CC-Ian/smartknob/cad/hacked-motor-mount 2.step

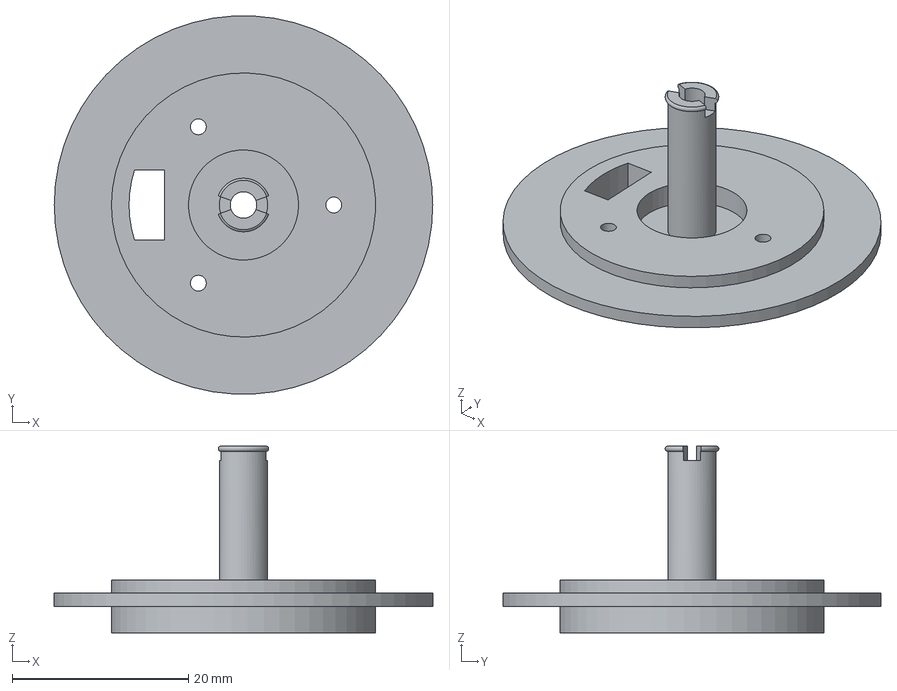
[picture p1: CAD file, 2025-04-29]
cad/hacked-motor-mount 2.step
43.0 x 42.9 x 21.2 mm
