CC-Ian/smartknob/electronics/view_base/LIB_WS2812B-4020/WS2812B-4020/3D/WS2812B-4020.stp

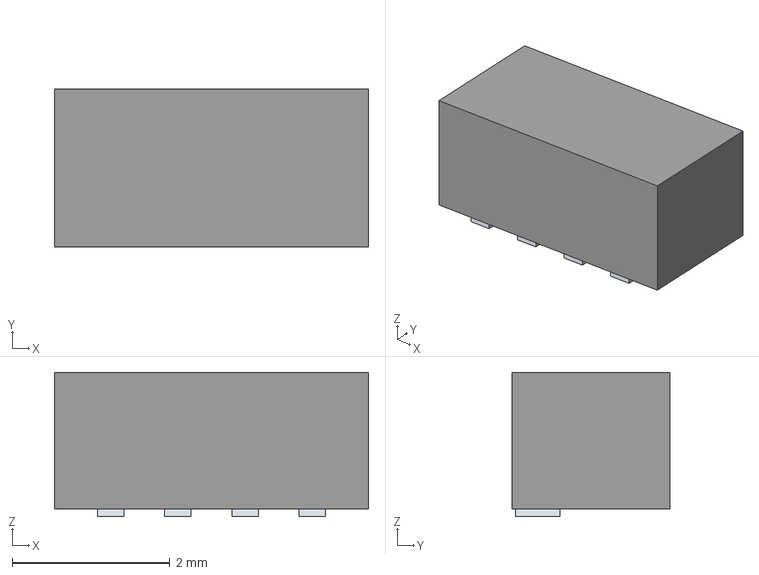
[picture p2: CAD file, 2025-03-28]
electronics/view_base/LIB_WS2812B-4020/WS2812B-4020/3D/WS2812B-4020.stp
3.98 x 2.00 x 1.83 mm
Pins
