CC-Ian/smartknob/cad/knob.step

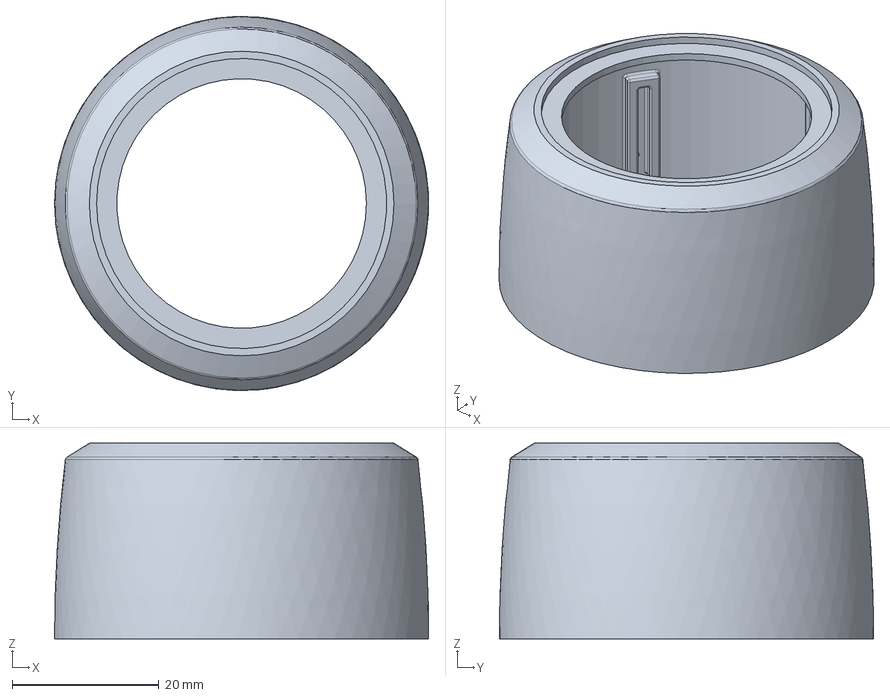
[picture p3: CAD file, 2025-04-29]
cad/knob.step
51.0 x 51.0 x 26.6 mm
