CC-Ian/smartknob/cad/Rotar Spacer.step

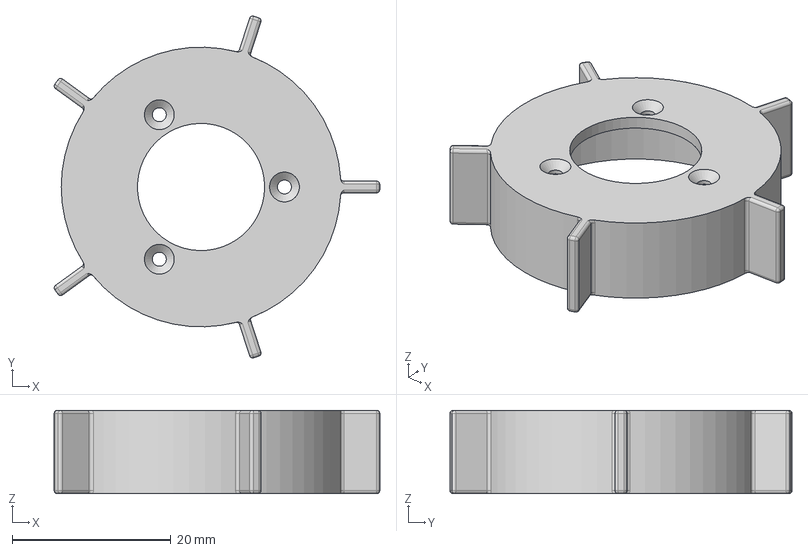
[picture p4: CAD file, 2025-04-29]
cad/Rotar Spacer.step
41.0 x 43.0 x 10.5 mm
