CC-Ian/smartknob/cad/hacked-motor-mount.step

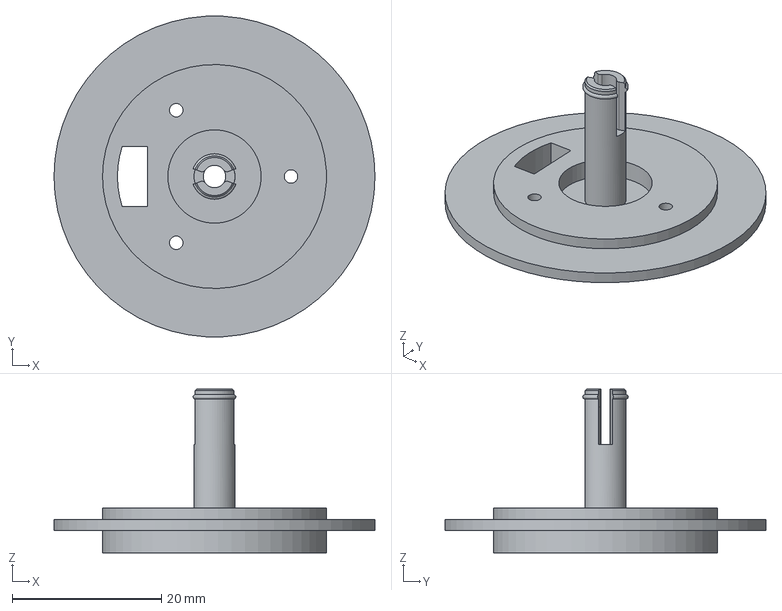
[picture p5: CAD file, 2025-04-29]
cad/hacked-motor-mount.step
43.0 x 42.9 x 21.9 mm
