CC-Ian/smartknob/cad/hacked rotor +.6mm.step

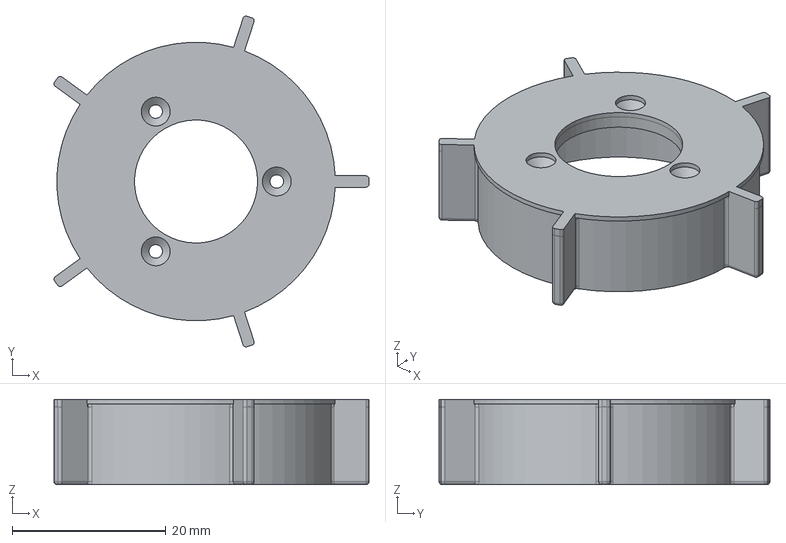
[picture p6: CAD file, 2025-04-29]
cad/hacked rotor +.6mm.step
41.0 x 43.0 x 11.1 mm
