CC-Ian/smartknob/cad/backplate.step

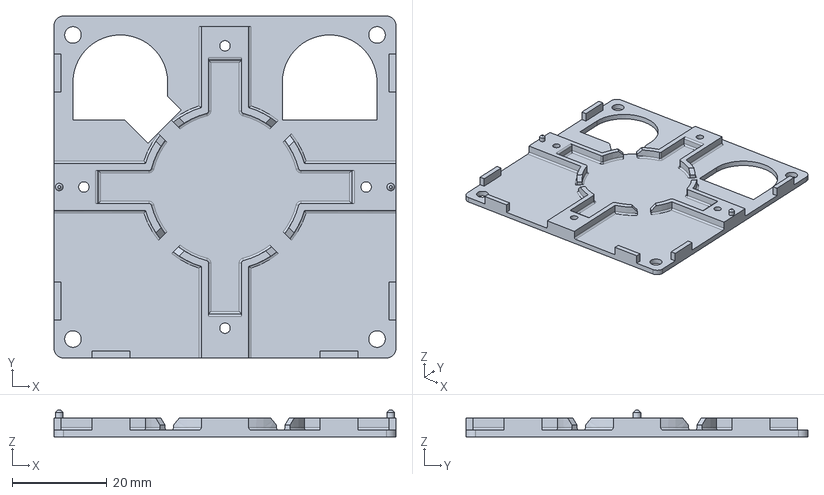
[picture p7: CAD file, 2025-03-28]
cad/backplate.step
72.2 x 72.2 x 5.70 mm
