CC-Ian/smartknob/cad/enclosure.step

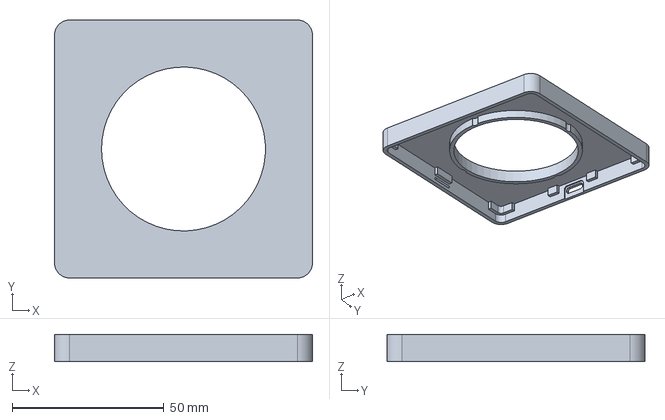
[picture p8: CAD file, 2025-03-28]
cad/enclosure.step
85.0 x 85.0 x 9.00 mm
