CC-Ian/smartknob/cad/screen platform.step

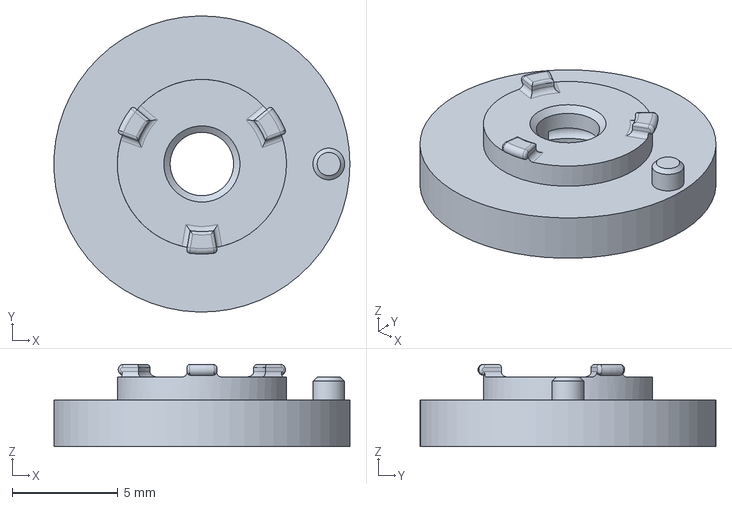
[picture p9: CAD file, 2025-03-28]
cad/screen platform.step
14.0 x 14.0 x 3.90 mm
