CC-Ian/smartknob/(list of files, cad)

Other CAD files:
cad/hacked-kbob.step
cad/base.step
