CC-Ian/smartknob/electronics/view_base/view_base.kicad_pcb

## KiCad design electronics/view_base/view_base.kicad_pcb (2025-04-29)

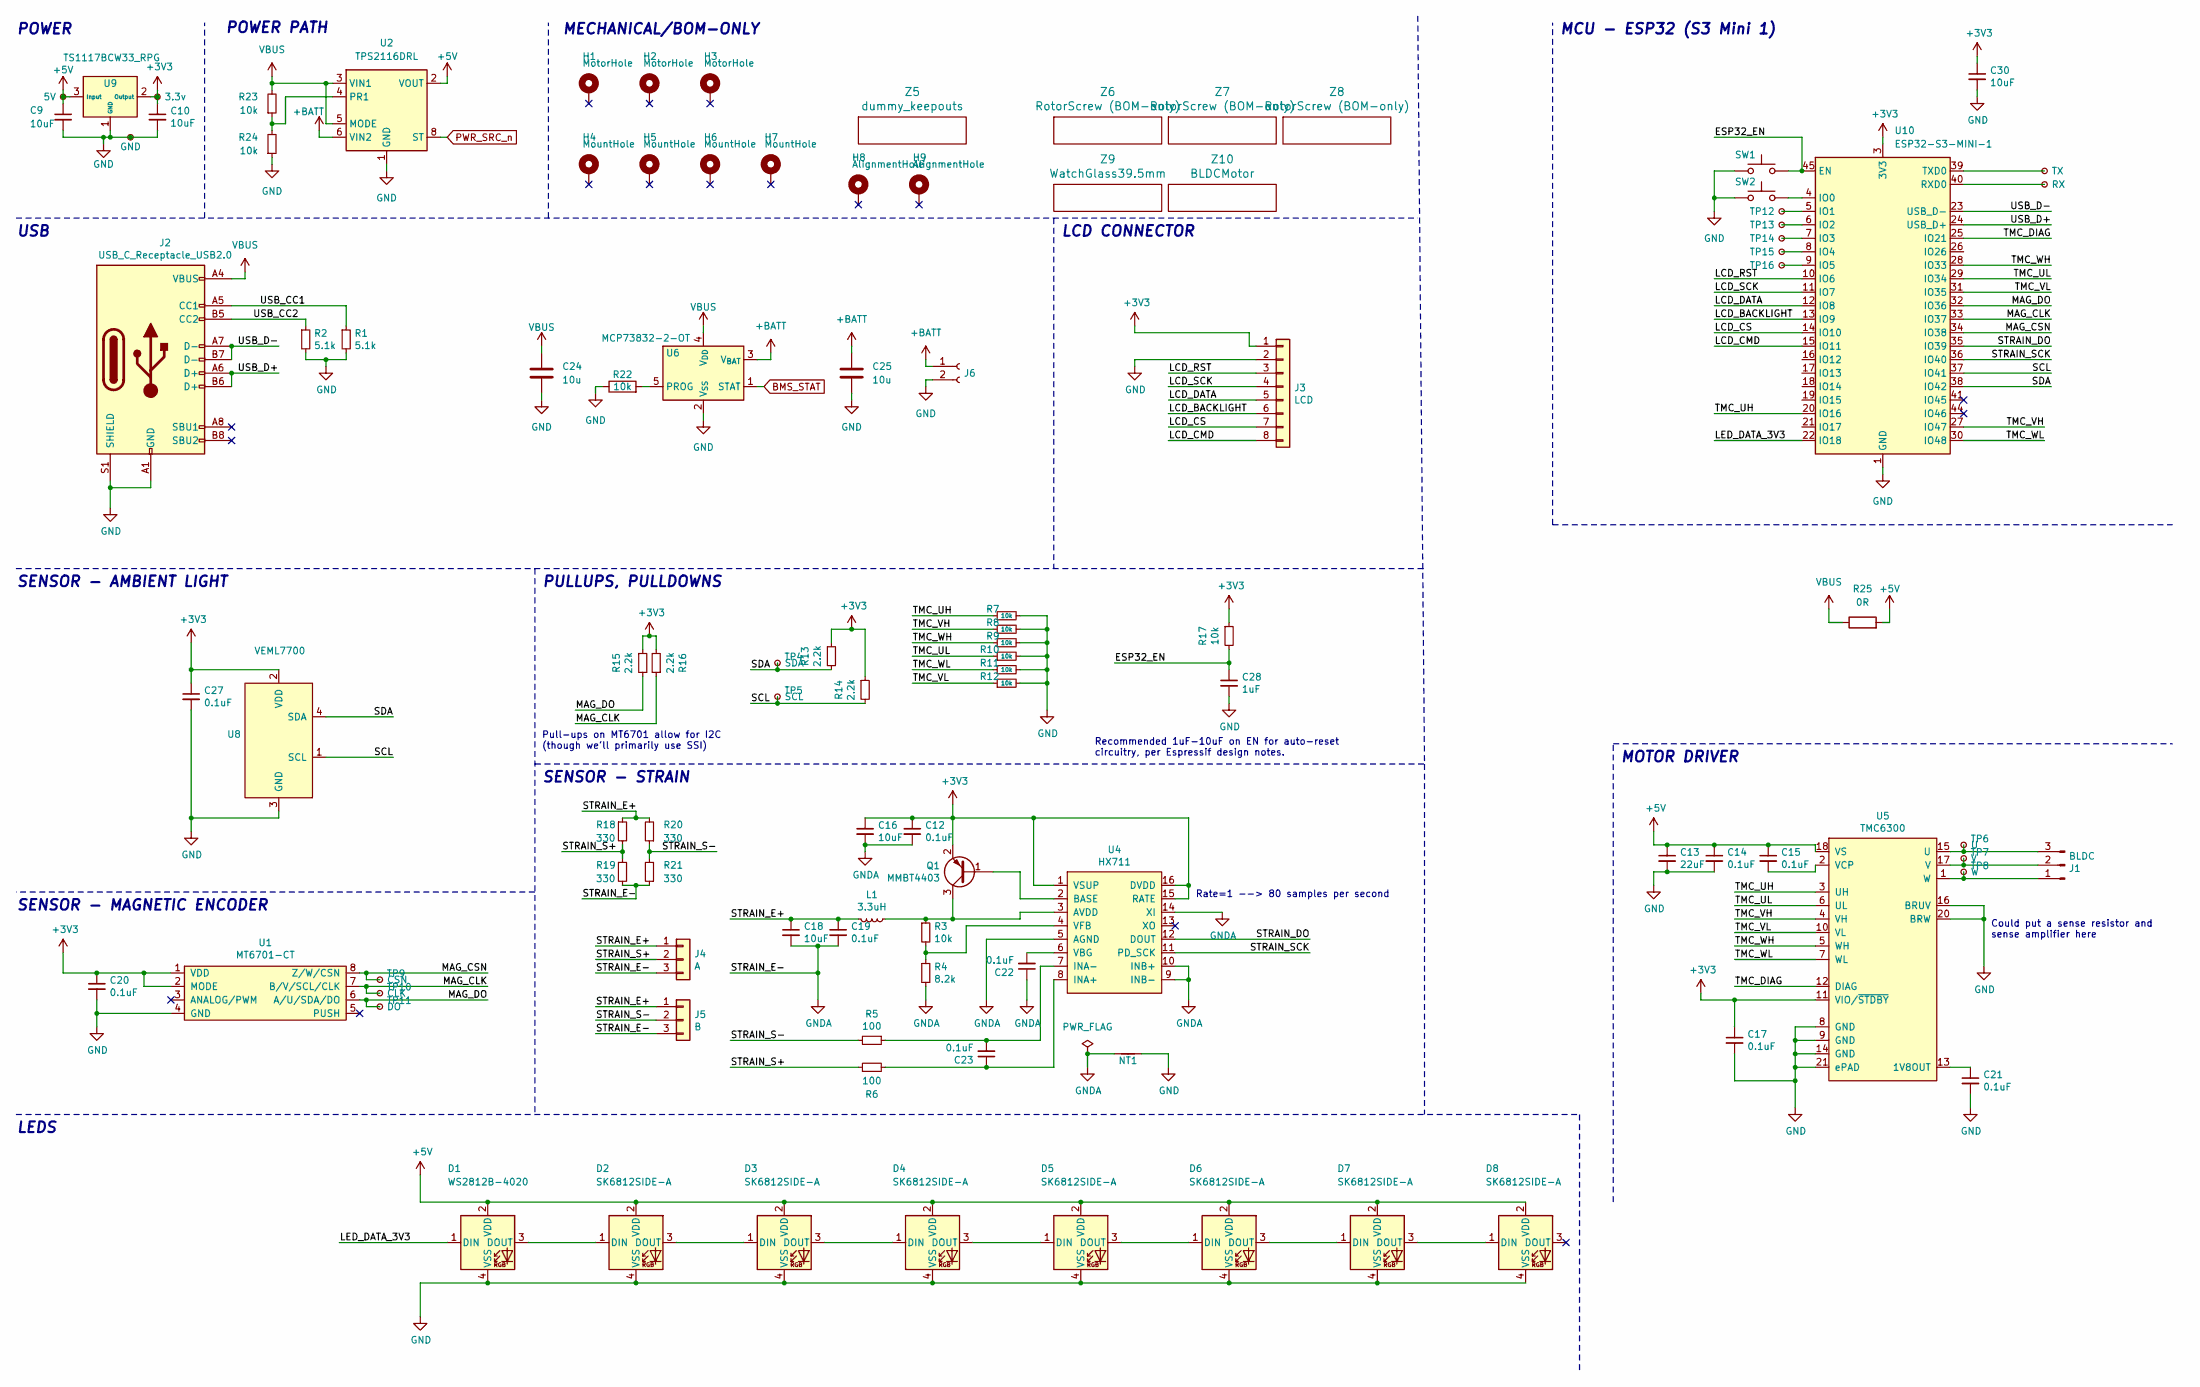
[picture p10: schematic view_base.kicad_sch, SmartKnob View]

Parts:
C9, C10, C16, C18, C30: 10uF; C_0603_1608Metric; LCSC C2922480
C12, C14, C15, C17, C19, C20, C21, C22, C23, C27: 0.1uF; C_0402_1005Metric; LCSC C1591
C13: 22uF; C_0603_1608Metric; LCSC C98190
C24, C25: 10u; C_0603_1608Metric
C28: 1uF; C_0402_1005Metric; Mouser 187-CL10A105KA8NNNC
D1: WS2812B-4020; WS2812B4020; Digikey 1528-4691-ND
D2, D3, D4, D5, D6, D7, D8: SK6812SIDE-A; WS2812B4020; Digikey 1528-4691-ND
H1, H2, H3: MotorHole; MountingHole_M1.6; LCSC C2931389
H4, H5, H6, H7: MountHole; MountingHole_2.2mm_M2_ISO7380_Pad_NonVirtual; LCSC C2911210 or C2911532 (screw), C2961595 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
H8, H9: AlignmentHole; MountingHole_2.2mm_M2_ISO7380_Pad_NonVirtual
J1: BLDC; 532610371; LCSC C293630
J2: USB_C_Receptacle_USB2.0; USB4510_NoPaste; LCSC C428463
J3: LCD; SolderPads_2mm_8
J4: A; SolderPads_2mm_3_STRAIN
J5: B; SolderPads_2mm_3_STRAIN
J6: Conn_01x02_Socket; PinHeader_1x02_P2.00mm_Vertical
L1: 3.3uH; L_0603_1608Metric; LCSC C307744
NT1: NetTie_2; NetTie-2_SMD_Pad0.5mm
Q1: MMBT4403; SOT-23; LCSC C78864
R1, R2: 5.1k; R_0402_1005Metric; LCSC C105580
R3, R7, R8, R9, R10, R11, R12, R17: 10k; R_0402_1005Metric; LCSC C98220
R4: 8.2k; R_0402_1005Metric; LCSC C114637
R5, R6: 100; R_0402_1005Metric; LCSC C319953
R13, R14, R15, R16: 2.2k; R_0402_1005Metric; LCSC C4190
R18, R19, R20, R21: 330; R_2512_6332Metric; LCSC C19866
R22, R23, R24: 10k; R_0402_1005Metric
R25: 0R; R_0603_1608Metric
SW1, SW2: SW_Push; T1B2QR
TP1: 5V; TestPoint_Pad_D2.0mm_ValueSilk
TP2: 3.3v; TestPoint_Pad_D2.0mm_ValueSilk
TP3: GND; TestPoint_Pad_D2.0mm_ValueSilk
TP4: SDA; TestPoint_Pad_D2.0mm_ValueSilk
TP5: SCL; TestPoint_Pad_D2.0mm_ValueSilk
TP6: U; TestPoint_Pad_D2.0mm_ValueSilk
TP7: V; TestPoint_Pad_D2.0mm_ValueSilk
TP8: W; TestPoint_Pad_D2.0mm_ValueSilk
TP9: CSN; TestPoint_Pad_D2.0mm_ValueSilk
TP10: CLK; TestPoint_Pad_D2.0mm_ValueSilk
TP11: DO; TestPoint_Pad_D2.0mm_ValueSilk
TP12, TP13, TP14, TP15, TP16: TestPoint_Small; TestPoint_Pad_D1.0mm
TP17: TX; TestPoint_Pad_D2.0mm_ValueSilk
TP18: RX; TestPoint_Pad_D2.0mm_ValueSilk
U1: MT6701-CT; SOIC-8_3.9x4.9mm_P1.27mm; LCSC C2856764, or C3003196
U2: TPS2116DRL; SOT-583-8; LCSC C3235557
U4: HX711; SOIC-16_3.9x9.9mm_P1.27mm; LCSC C43656
U5: TMC6300; QFN-20-1EP_3x3mm_P0.4mm_EP1.65x1.65mm; Digikey TMC6300-LA-T
U6: MCP73832-2-OT; SOT-23-5; LCSC C38066
U8: VEML7700; VEML7700-TOP; Digikey VEML7700-TT
U9: TS1117BCW33_RPG; SOT-223-3_TabPin2_GndOutIn; LCSC C6186
U10: ESP32-S3-MINI-1; ESP32-S2-MINI-1; LCSC C2913206
Z5: dummy_keepouts; ViewKeepouts3d
Z6, Z7, Z8: RotorScrew (BOM-only); bom_only_no_pin
Z9: WatchGlass39.5mm; bom_only_no_pin
Z10: BLDCMotor; bom_only_no_pin

Connections:
+3V3: C10.1, C12.1, C16.1, C17.1, C20.1, C27.1, C30.1, J3.1, Q1.2 (E), R13.1, R14.1, R15.1, R16.2, R17.1, TP2.1, U1.1 (VDD), U1.2 (MODE), U4.1 (VSUP), U4.15 (RATE), U4.16 (DVDD), U5.11 (VIO/~STDBY), U8.2 (VDD), U9.2 (Output), U10.3 (3V3)
+5V: C9.1, C13.1, C14.1, C15.1, D1.2 (VDD), D2.2 (VDD), D3.2 (VDD), D4.2 (VDD), D5.2 (VDD), D6.2 (VDD), D7.2 (VDD), D8.2 (VDD), R25.2, TP1.1, U2.2 (VOUT), U2.7 (VOUT), U5.18 (VS), U9.3 (Input)
+BATT: C25.1, J6.1, U2.6 (VIN2), U6.3 (V_{BAT})
/ESP32_EN: C28.1, R17.2, SW1.2, U10.45 (EN)
/LCD_BACKLIGHT: J3.6, U10.13 (IO9)
/LCD_CMD: J3.8, U10.15 (IO11)
/LCD_CS: J3.7, U10.14 (IO10)
/LCD_DATA: J3.5, U10.12 (IO8)
/LCD_RST: J3.3, U10.10 (IO6)
/LCD_SCK: J3.4, U10.11 (IO7)
/LED_DATA_3V3: D1.1 (DIN), U10.22 (IO18)
/MAG_CLK: R16.1, TP10.1, U1.7 (B/V/SCL/CLK), U10.33 (IO37)
/MAG_CSN: TP9.1, U1.8 (Z/W/CSN), U10.34 (IO38)
/MAG_DO: R15.2, TP11.1, U1.6 (A/U/SDA/DO), U10.32 (IO36)
/SCL: R14.2, TP5.1, U8.1 (SCL), U10.37 (IO41)
/SDA: R13.2, TP4.1, U8.4 (SDA), U10.38 (IO42)
/STRAIN_DO: U4.12 (DOUT), U10.35 (IO39)
/STRAIN_E+: C18.1, C19.1, J4.1, J5.1, L1.2, R18.1, R20.2
/STRAIN_S+: J4.2, R6.1, R18.2, R19.1
/STRAIN_S-: J5.2, R5.2, R20.1, R21.2
/STRAIN_SCK: U4.11 (PD_SCK), U10.36 (IO40)
/TMC_DIAG: U5.12 (DIAG), U10.25 (IO21)
/TMC_UH: R7.1, U5.3 (UH), U10.20 (IO16)
/TMC_UL: R10.1, U5.6 (UL), U10.29 (IO34)
/TMC_VH: R8.1, U5.4 (VH), U10.27 (IO47)
/TMC_VL: R12.1, U5.10 (VL), U10.31 (IO35)
/TMC_WH: R9.1, U5.5 (WH), U10.28 (IO33)
/TMC_WL: R11.1, U5.7 (WL), U10.30 (IO48)
/USB_CC1: J2.A5 (CC1), R1.1
/USB_CC2: J2.B5 (CC2), R2.1
/USB_D+: J2.A6 (D+), J2.B6 (D+), U10.24 (USB_D+)
/USB_D-: J2.A7 (D-), J2.B7 (D-), U10.23 (USB_D-)
BMS_STAT: U6.1 (STAT)
GND: C9.2, C10.2, C13.2, C14.2, C17.2, C20.2, C21.2, C24.2, C25.2, C27.2, C28.2, C30.2, D1.4 (VSS), D2.4 (VSS), D3.4 (VSS), D4.4 (VSS), D5.4 (VSS), D6.4 (VSS), D7.4 (VSS), D8.4 (VSS), J2.A1 (GND), J2.A12 (GND), J2.B1 (GND), J2.B12 (GND), J2.S1 (SHIELD), J3.2, J6.2, NT1.2, R1.2, R2.2, R7.2, R8.2, R9.2, R10.2, R11.2, R12.2, R22.1, R24.1, SW1.1, SW2.1, TP3.1, U1.4 (GND), U2.1 (GND), U5.8 (GND), U5.9 (GND), U5.14 (GND), U5.16 (BRUV), U5.20 (BRW), U5.21 (ePAD), U6.2 (V_{SS}), U8.3 (GND), U9.1 (GND), U10.1 (GND), U10.2 (GND), U10.42 (GND), U10.43 (GND), U10.46 (GND), U10.47 (GND), U10.48 (GND), U10.49 (GND), U10.50 (GND), U10.51 (GND), U10.52 (GND), U10.53 (GND), U10.54 (GND), U10.55 (GND), U10.56 (GND), U10.57 (GND), U10.58 (GND), U10.59 (GND), U10.60 (GND), U10.61 (GND), U10.62 (GND), U10.63 (GND), U10.64 (GND), U10.65 (GND)
GNDA: C12.2, C16.2, C18.2, C19.2, C22.1, J4.3, J5.3, NT1.1, R4.2, R19.2, R21.1, U4.5 (AGND), U4.9 (INB-), U4.10 (INB+), U4.14 (XI)
unnamed: D1.3 (DOUT), D2.1 (DIN)
unnamed: D2.3 (DOUT), D3.1 (DIN)
unnamed: D3.3 (DOUT), D4.1 (DIN)
unnamed: D4.3 (DOUT), D5.1 (DIN)
unnamed: D5.3 (DOUT), D6.1 (DIN)
unnamed: D6.3 (DOUT), D7.1 (DIN)
unnamed: D7.3 (DOUT), D8.1 (DIN)
unnamed: J1.1, TP8.1, U5.1 (W)
unnamed: J1.2, TP7.1, U5.17 (V)
unnamed: J1.3, TP6.1, U5.15 (U)
unnamed: Q1.1 (B), U4.2 (BASE)
unnamed: L1.1, Q1.3 (C), R3.1, U4.3 (AVDD)
unnamed: R23.1, R24.2, U2.4 (PR1)
unnamed: C23.1, R6.2, U4.8 (INA+)
unnamed: C23.2, R5.1, U4.7 (INA-)
unnamed: C22.2, U4.6 (VBG)
unnamed: R3.2, R4.1, U4.4 (VFB)
unnamed: C21.1, U5.13 (1V8OUT)
unnamed: C15.2, U5.2 (VCP)
unnamed: R22.2, U6.5 (PROG)
unnamed: SW2.2, U10.4 (IO0)
unnamed: TP12.1, U10.5 (IO1)
unnamed: TP13.1, U10.6 (IO2)
unnamed: TP14.1, U10.7 (IO3)
unnamed: TP15.1, U10.8 (IO4)
unnamed: TP16.1, U10.9 (IO5)
unnamed: TP18.1, U10.40 (RXD0)
unnamed: TP17.1, U10.39 (TXD0)
PWR_SRC_n: U2.8 (ST)
VBUS: C24.1, J2.A4 (VBUS), J2.A9 (VBUS), J2.B4 (VBUS), J2.B9 (VBUS), R23.2, R25.1, U2.3 (VIN1), U2.5 (MODE), U6.4 (V_{DD})

Notes on the sheet:
POWER PATH
MECHANICAL/BOM-ONLY
USB
Could put a sense resistor and sense amplifier here
Pull-ups on MT6701 allow for I2C (though we'll primarily use SSI)
SENSOR - MAGNETIC ENCODER
PULLUPS, PULLDOWNS
LEDS
Recommended 1uF-10uF on EN for auto-reset circuitry, per Espressif design notes.
MCU - ESP32 (S3 Mini 1)
LCD CONNECTOR
POWER
Rate=1 --> 80 samples per second
MOTOR DRIVER
SENSOR - AMBIENT LIGHT
SENSOR - STRAIN

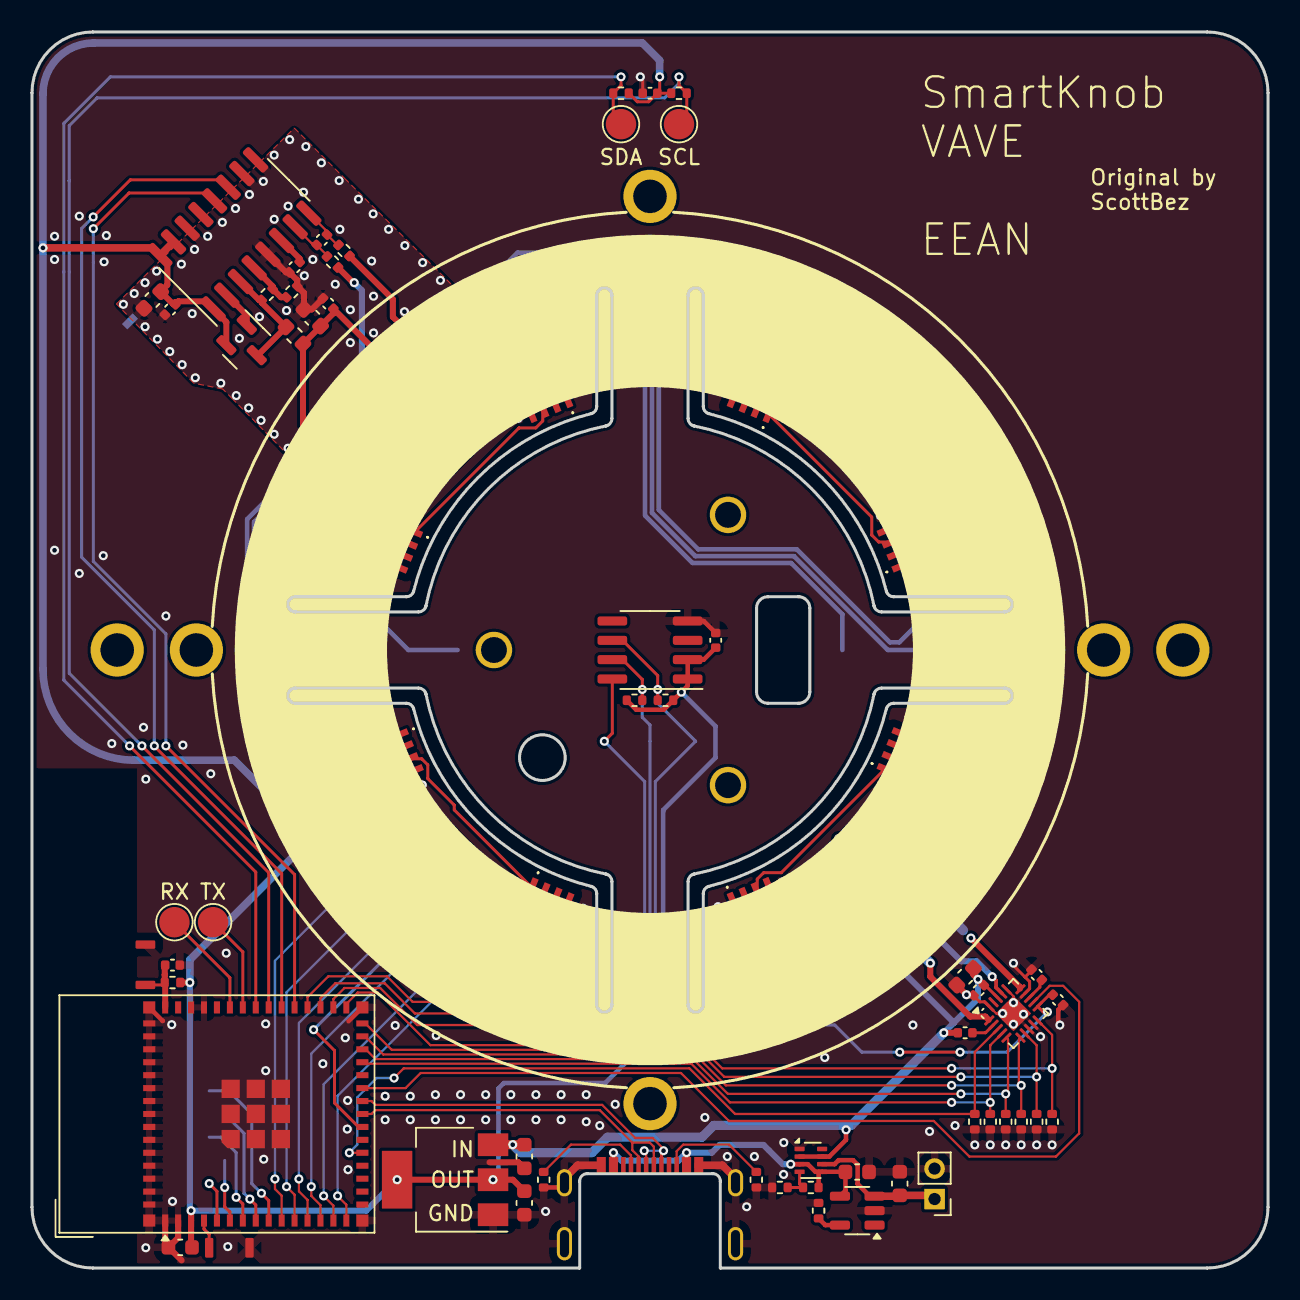
[picture p11: board view_base.kicad_pcb from above]

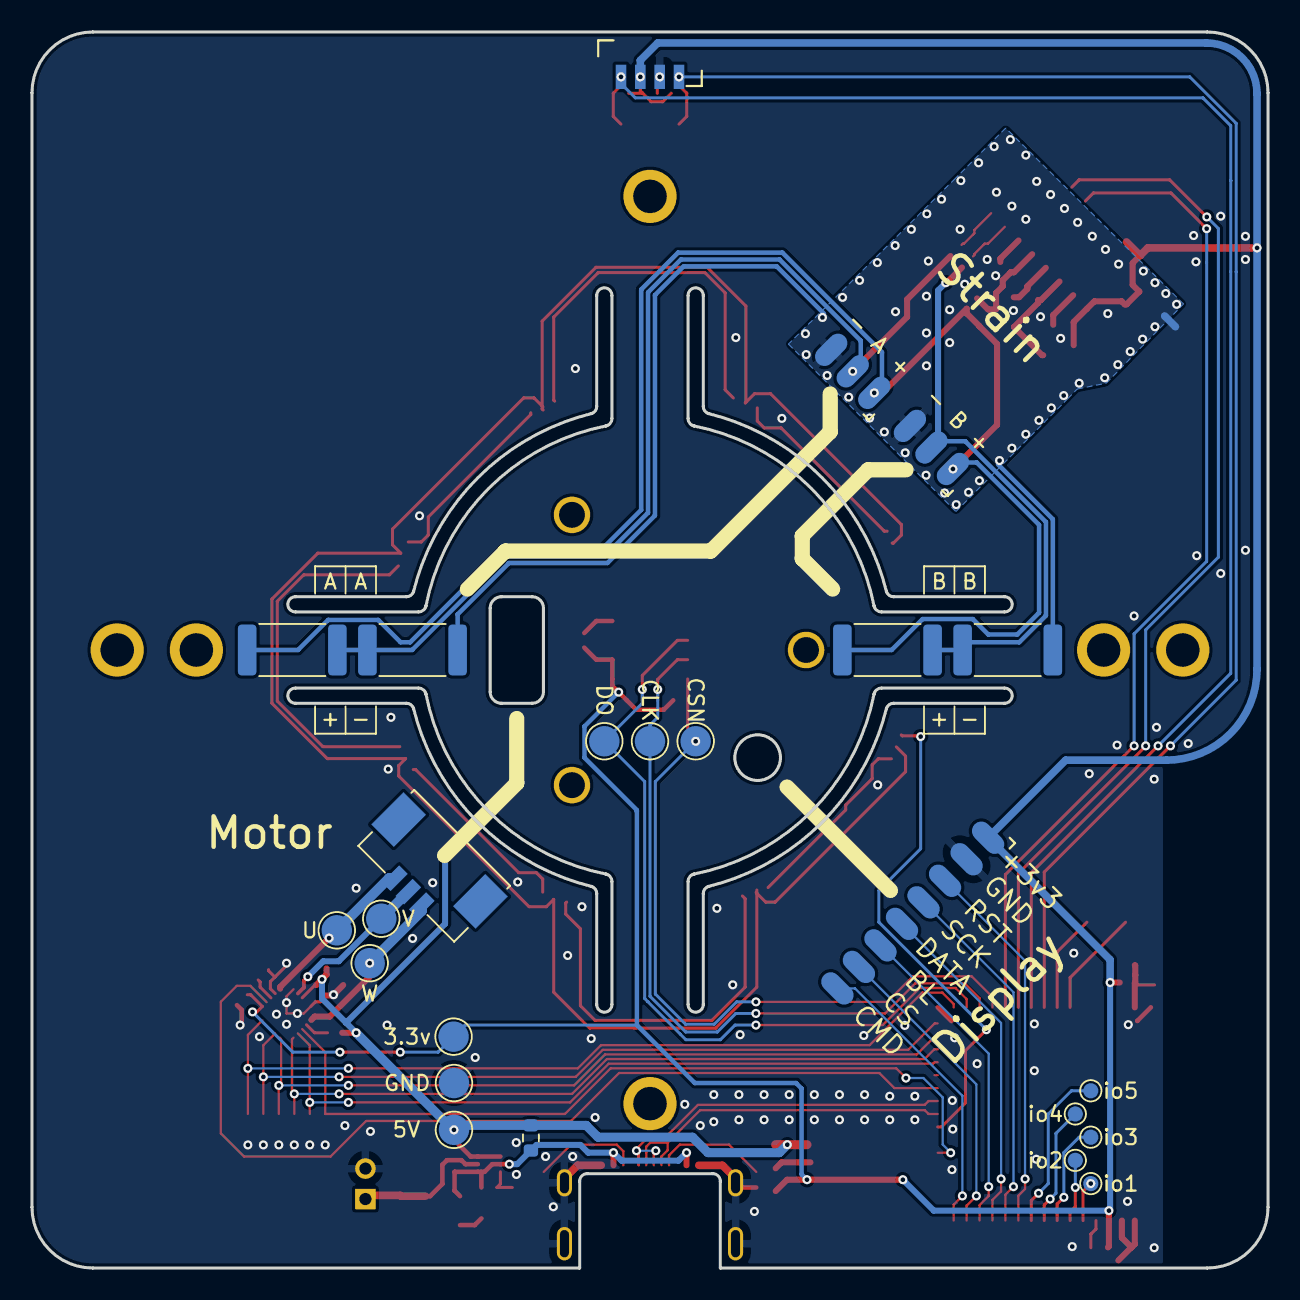
[picture p12: board view_base.kicad_pcb from below]

Board: 2 copper layers, 81.2 x 81.2 mm, 103 parts (25 on the bottom side), 63 nets.
