CC-Ian/smartknob/(commit log)

2025-03-25 Initial start
    [view_base.kicad_pcb, view_screen.kicad_pcb, view_screen.kicad_sch]
2025-03-28 Almost entirely completed vave
    [WS2812B-4020.stp, backplate.step, base.step, enclosure.step, screen platform.step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]
2025-03-30 Ordered Revision A
    [view_base-B_Cu.gbr, view_base-B_Mask.gbr, view_base-B_Paste.gbr, view_base-B_Silkscreen.gbr, view_base-Edge_Cuts.gbr, view_base-F_Cu.gbr, view_base-F_Mask.gbr, view_base-F_Paste.gbr]
2025-04-29 Almost done. pending BOM
    [BM28B0.6-24DSBreakout.kicad_pcb, BM28B0.6-24DSBreakout.sch, LevelShifterBreakout.kicad_pcb, LevelShifterBreakout.sch, Rotar Spacer.step, configuration.h, default_ffat_8MB.csv, hacked rotor +.6mm.step]
